almamun120/LoRa-MeshChat-Node/MeshChat-LoRa-Node-v1.5/README.md

# MeshChat LoRa রিলে নোড (ESP32 + RA-02)

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

## ফার্মওয়্যার ১.২ (অ্যাপ ২.১১-এর সাথে)

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

## ৫. টেস্ট চালানো (পিসিতে)
```bash
sudo apt install g++ libssl-dev
make -C test run                 # মেশ কোর: ১৪৮টি চেক (রিলে চেইন P1–A~LoRa~B–P2, ক্ষতি/রিট্রাই, ডিউটি সাইকেল…)
tools/interop.sh                 # অ্যাপের আসল Kotlin কোডের সাথে ক্রস-চেক (অ্যাপের কোর কম্পাইল করা থাকতে হবে)
```

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

আরও: **`docs/HOW_IT_WORKS.md`** (প্রোটোকল ও সীমাবদ্ধতা)।

## ⌨ ব্লুটুথ কীবোর্ড (১.৫)
- রিলে **BLE** কীবোর্ড (HID over GATT) জোড়া যায়; লেখা PS/2 কীবোর্ডের মতোই চ্যাটে যায়। সাধারণ ক্লাসিক-ব্লুটুথ কীবোর্ড চলবে না, শুধু BLE।
- জোড়া লাগানো: সেটআপ পেজ → "ব্লুটুথ কীবোর্ড" → 🔍 খুঁজুন (কীবোর্ডকে আগে পেয়ারিং মোডে দিন) → Pair। LCD/ওয়েবে ৬ অঙ্কের কোড আসে, সেটি কীবোর্ডে টাইপ করে Enter দিন (কিছু কীবোর্ড কোড চায় না)।
- একবার জোড়া হলে কীবোর্ড জাগলেই আপনা-আপনি যুক্ত হয়; ৪টি ফোনের সংযোগে বাধা দেয় না। কোনো নতুন তার লাগে না।
- পরীক্ষা: কী-কোড থেকে অক্ষর (`mc_hid`) পিসিতে পরীক্ষিত। ESP32-তে স্ক্যান/পেয়ারিং কোড আমি কম্পাইল বা বাস্তব কীবোর্ডে চালাইনি।
