almamun120/LoRa-MeshChat-Node/MeshChat-LoRa-Node-v1.5/docs/HOW_IT_WORKS.md

# কীভাবে কাজ করে / How the relay works

```
 ফোন (MeshChat) ──BLE──┐                                   ┌──BLE── ফোন (MeshChat)
 ফোন (MeshChat) ──BLE──┤  [রিলে A]  ~~~~ LoRa ~~~~  [রিলে B]  ├──BLE── ফোন (MeshChat)
 ওয়েব/Wi-Fi, কিবোর্ড+LCD ┘   ESP32                      ESP32   └── ওয়েব/Wi-Fi, কিবোর্ড+LCD
```

## BLE দিকে
- রিলে নিজেকে হুবহু একটি MeshChat ফোনের মতো দেখায়: একই GATT সার্ভিস/ক্যারেকটারিস্টিক UUID, একই অ্যাডভার্টাইজমেন্ট (service UUID + `proto|caps|nodeId`), একই ফ্রেম ফরম্যাট (3 বাইট হেডার), একই HELLO দিয়ে লিংক বাঁধা। **ফোনের অ্যাপে কোনো বদল লাগে না**: ফোন রিলেকে স্ক্যান করে নিজে থেকেই সংযুক্ত হয়।
- রিলের Node ID ইচ্ছা করে বড় (F0… দিয়ে শুরু) বানানো হয়, যাতে ফোনই (ছোট ID) কানেকশন খোলে; রিলে কখনো বাইরে ডায়াল করে না।
- একসাথে ৪টি ফোন পর্যন্ত।
- প্রতি ১০ সেকেন্ডে প্রতিটি ফোনকে HELLO পাঠায়, যাতে দূরের (LoRa-র ওপারের) নোডের রুট বিজ্ঞাপিত থাকে। তাই ফোন জানে "ঐ নোডে পৌঁছাতে রিলের মধ্য দিয়ে যেতে হবে।"

## LoRa দিকে
- মেশ প্যাকেট (অ্যাপের ফরম্যাট অপরিবর্তিত) ১টি বা কয়েকটি রেডিও ফ্রেমে (সর্বোচ্চ ২৫৫ বাইট) ভেঙে যায়, সর্বোচ্চ ৮ ফ্রেম (~২ KB)।
- LoRa-য় যায়: **IDENTITY (পরিচয়/পাবলিক কি), ANNOUNCE (পাবলিক বোর্ড), PRIVATE (এনক্রিপ্টেড চ্যাট), ACK, SOS**।
- LoRa-য় যায় না: ছবি, ভয়েস, কল, ফাইল (এগুলো অনেক বড়/দ্রুত; ওগুলো শুধু BLE/Wi-Fi Direct-এ চলে)।
- **ফ্লাডিং + TTL + ডুপ্লিকেট ক্যাশ:** একই প্যাকেট দুবার প্রসেস হয় না, প্রতি হপে TTL কমে। অন্য রিলে আগেই পুনঃপ্রচার করেছে শুনলে নিজের পুনঃপ্রচার বাতিল ("heard-repeat cancel")।
- **ডিউটি সাইকেল:** ট্রান্সমিটের পর airtime × (100/duty − 1) সময় চুপ থাকে (ডিফল্ট 10%)।
- **পরিচয় বীকন:** ফোন রিলের সাথে যুক্ত হলে তার সাইন করা IDENTITY রিলে মনে রাখে এবং LoRa-য় প্রচার করে (শুরুতে কয়েকবার তাড়াতাড়ি, তারপর ১২ মিনিট পরপর)। দূরের রিলে সেটা তার ফোনগুলোকে দেয়। এভাবে দুই প্রান্তের মানুষ একে অন্যের পাবলিক কি পায় এবং এন্ড-টু-এন্ড এনক্রিপ্টেড চ্যাট শুরু করতে পারে। রিলে IDENTITY-র সিগনেচার যাচাই করে, জাল পরিচয় বা বদলানো কি আটকায়।
- **অ্যাপ ২.১১ / ফার্মওয়্যার ১.২ সহযোগিতা: HELLO-তে LoRa-পথ চিহ্ন (অ্যাপ ঐ নোডে ভয়েস/ফাইল/কল বন্ধ করে),** রিলে `LORA` ক্যাপ বিট জানায়, ফোনের পুনরাবৃত্ত পরিচয় LoRa-তে পাঠায় না (শুধু নতুন পরিচয় ও বীকন), পাবলিক পোস্ট/পরিচয়ের LoRa হপ সীমা ৬, পরিচয়-অনুরোধ (টাইপ ১২) মেমরি থেকে উত্তর দেয়, ট্রান্সমিটের আগে চ্যানেল শোনে, চ্যানেল ব্যস্ত হলে বীকন ধীর করে।
- **রিট্রাই:** ফোনের পুনঃপ্রেরণ (৮, ১৬, ৩২, ৬৪, ১২০ সেকেন্ড) যেন LoRa-য় হারানো প্যাকেট ঠেকাতে পারে, তাই অন্যের জন্য প্যাকেটের "ডুপ্লিকেট" গার্ড খুব ছোট (৭–৩০ সেকেন্ড)।

## আবহাওয়া স্টেশন (১.৪)
- নতুন প্যাকেট টাইপ বা চ্যাট পোস্ট নেই: IDENTITY পেলোডের শেষে ঐচ্ছিক ঘর — `[নাম][চাবি][ই-মেইল স্লট (ফাঁকা হতে পারে)] + °C×10 (int16) + hPa×10 (uint16)`, বিগ-এন্ডিয়ান। আবহাওয়া না থাকলে বাইট আগের ফরম্যাটের হুবহু একই। সংখ্যা -60..80 °C ও 300..1100 hPa-র বাইরে হলে পরিচয়টাই ভুল ধরা হয়।
- BMP280 একবার মাপে (ফোর্সড মোড, তাপ ×২, চাপ ×১৬), ডেটাশিটের ৩২-বিট পূর্ণসংখ্যা সূত্রে ক্ষতিপূরণ (`mc_weather.cpp`)।
- আবহাওয়াসহ পরিচয় যায় (ক) মালিকের ঠিক করা ব্যবধানে, (খ) ফোন যুক্ত হলে সেই ফোনকে। সাধারণ বীকন ও পরিচয়-অনুরোধের উত্তরে আবহাওয়া থাকে না।
- রিসিভ করা রিলে ওটা কন্টাক্টের সাথে রাখে ও **প্রতিবার "খবর" ধরে** ফোন ও পরের LoRa হপে পাঠায় (সাধারণ পরিচয় শুধু নতুন হলে যায়)। পুরোনো রিডিং পরে নতুন ফোনকে "রিপ্লে" করা হয় না (নইলে বাসি তাপমাত্রা নতুন দেখাত)।
- অ্যাপ শুধু মেমরিতে (ডাটাবেসে নয়) নোড ধরে শেষ রিডিং ও পাওয়ার সময় রাখে, Nearby তালিকায় "কত আগের" দেখায়।

## রিলের নিজের চ্যাট
- রিলের একটি নিজস্ব পরিচয় (P-256 কি) আছে; কি ফ্ল্যাশে সংরক্ষিত। Setup পেজ থেকে নতুন Node ID বানানো যায়।
- **পাবলিক বোর্ডে** লিখলে ANNOUNCE প্যাকেট (সাইন করা), লেখকের নাম = ওয়েবে আপনার দেওয়া নাম।
- **প্রাইভেট** মেসেজ ফোনের মতোই এনক্রিপ্টেড (ECDH + HKDF + AES-GCM), `[আপনার নাম] লেখা` প্রিফিক্সসহ। ACK এলে ✓✓।
- ⚠️ ডিভাইসটি একটি **শেয়ারড টার্মিনাল**: এর Wi-Fi/ওয়েব/LCD-র সবাই একই পরিচয়ে লেখে এবং রিলের প্রাইভেট চ্যাট সবাই দেখতে পায়। Wi-Fi পাসওয়ার্ড তাই গুরুত্বপূর্ণ। ব্যক্তিগত কথার জন্য নিজের ফোনের অ্যাপ ব্যবহার করুন।

## সীমাবদ্ধতা
- ফোন-ফোন গ্রুপ চ্যাট: রিলে গ্রুপ মেসেজ পড়ে দেখাতে পারে (`[group]` প্রিফিক্সসহ), কিন্তু গ্রুপে লিখতে পারে না।
- ছবি/ভয়েস মেসেজ রিলের স্ক্রিনে "[photo]" বা "[voice]" লেখা দেখায়।
- রিলে ঘড়ি নেই: ওয়েব পেজ খুললে ব্রাউজারের সময় নেয় (বা অন্য প্যাকেট থেকে শেখে)।
- SF বেশি (11–12) হলে দূরত্ব বাড়ে কিন্তু একটি প্যাকেটে কয়েক সেকেন্ড লাগে এবং ডিউটি সাইকেলের কারণে মেসেজ ধীরে যায়।

## ব্লুটুথ কীবোর্ড (১.৫)
রিলে একটি `BtKeyboard` টাস্ক আলাদা থ্রেডে চলে: স্ক্যান → কানেক্ট → পেয়ারিং (প্যাসকি রিলে দেখায়) → HID রিপোর্ট নোটিফাই। রিপোর্টের বাইট `mc_hid` কী-ইভেন্টে বদলায়, তারপর PS/2-র মতোই `ChatUi`-তে যায়। এটি BLE সেন্ট্রাল হিসেবে চলে, ফোনেরা আগের মতোই রিলের সার্ভারে যুক্ত হয়।
