almamun120/LoRa-MeshChat-Node/MeshChat-LoRa-Node-v1.5/docs/app_screens/00_overview.png

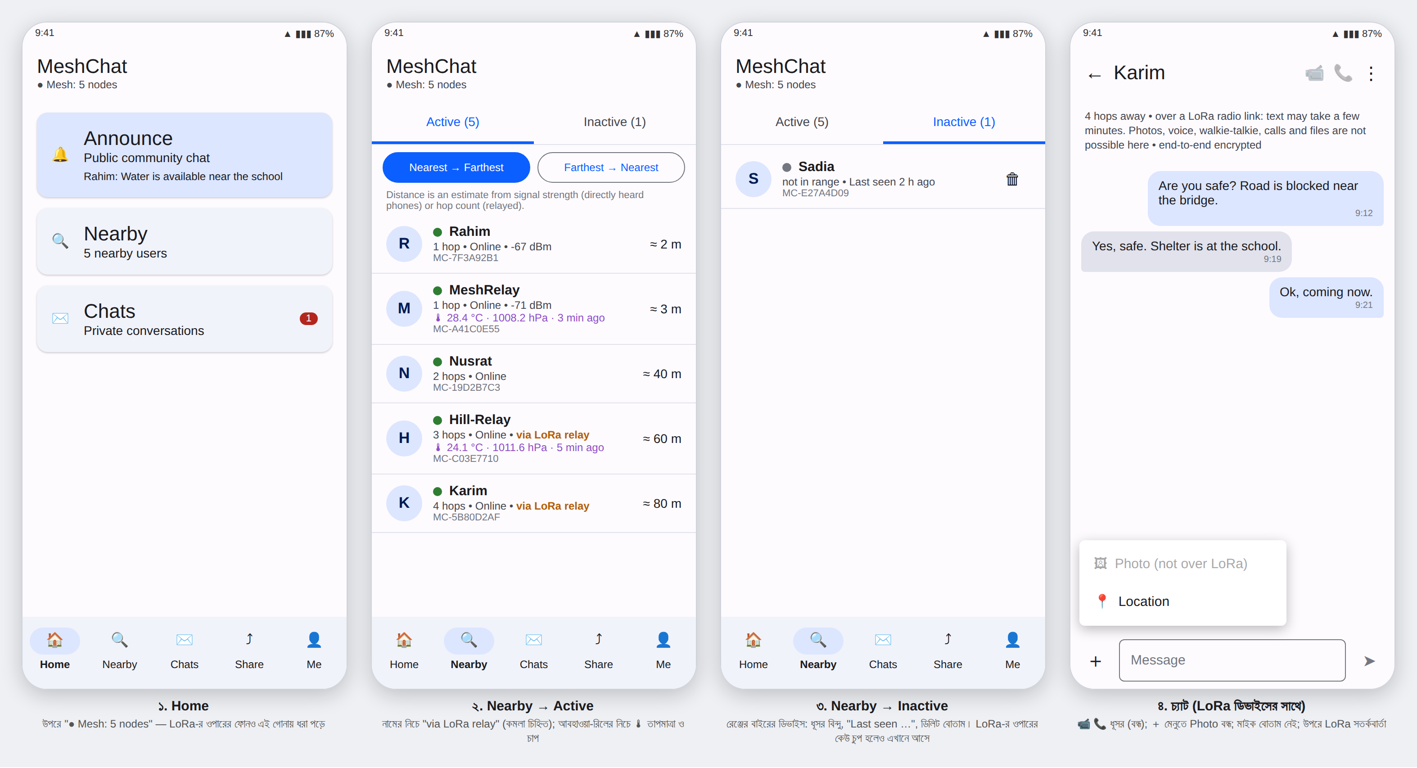
MeshChat-LoRa-Node-v1.5/docs/app_screens/00_overview.png
