almamun120/LoRa-MeshChat-Node/MeshChat-LoRa-Node-v1.5/docs/app_screens/01_home.png

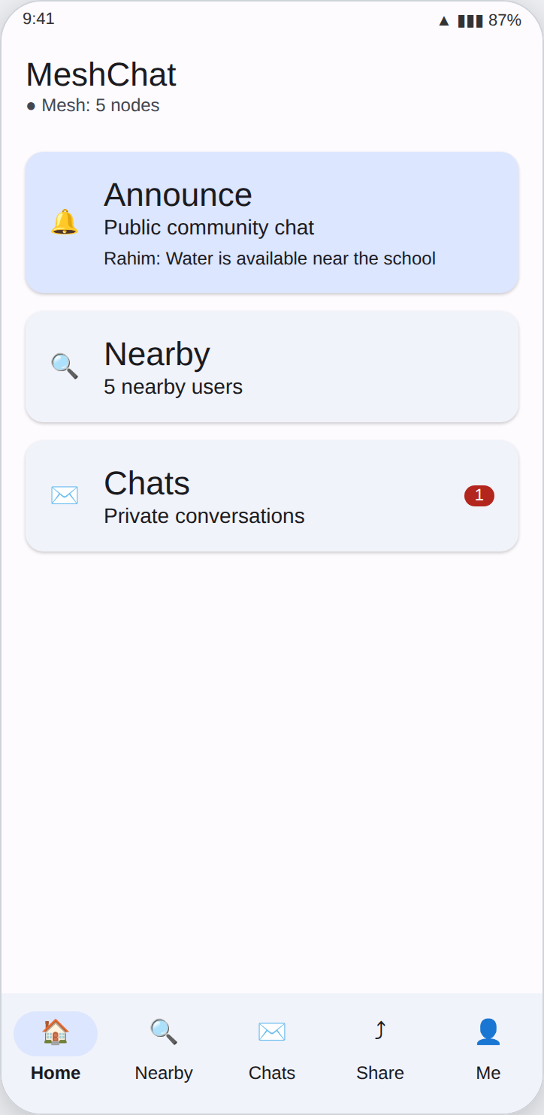
MeshChat-LoRa-Node-v1.5/docs/app_screens/01_home.png
