almamun120/LoRa-MeshChat-Node/MeshChat-LoRa-Node-v1.5/docs/app_screens/02_nearby_active.png

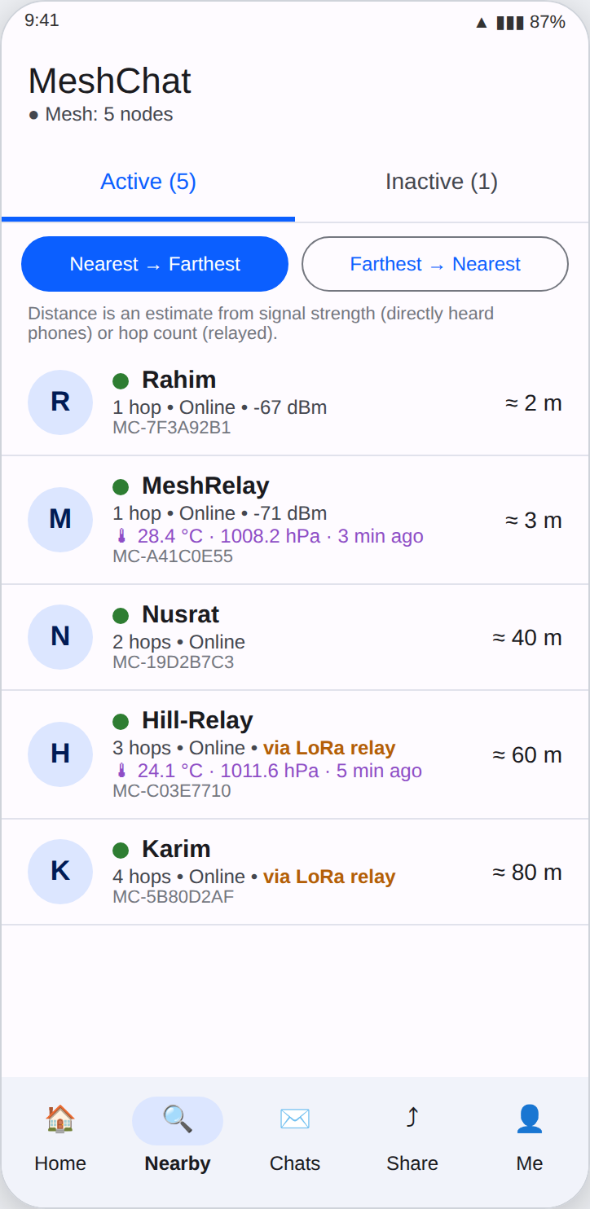
MeshChat-LoRa-Node-v1.5/docs/app_screens/02_nearby_active.png
