almamun120/LoRa-MeshChat-Node/MeshChat-LoRa-Node-v1.5/docs/app_screens/03_nearby_inactive.png

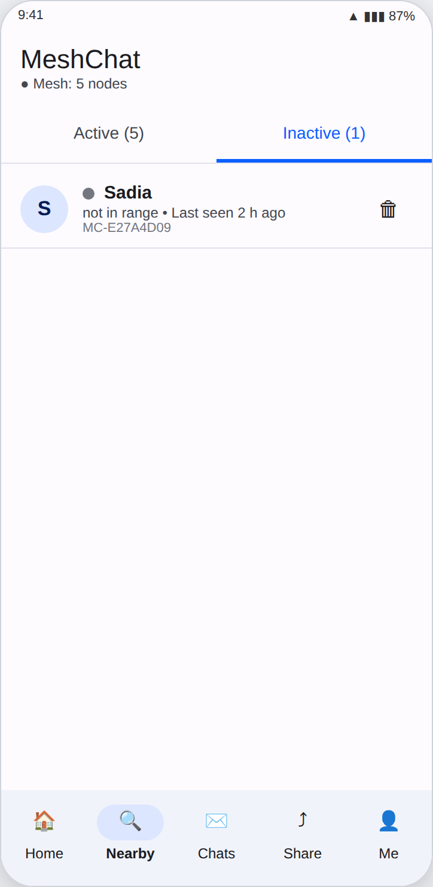
MeshChat-LoRa-Node-v1.5/docs/app_screens/03_nearby_inactive.png
