almamun120/LoRa-MeshChat-Node/MeshChat-LoRa-Node-v1.5/docs/app_screens/04_chat_lora.png

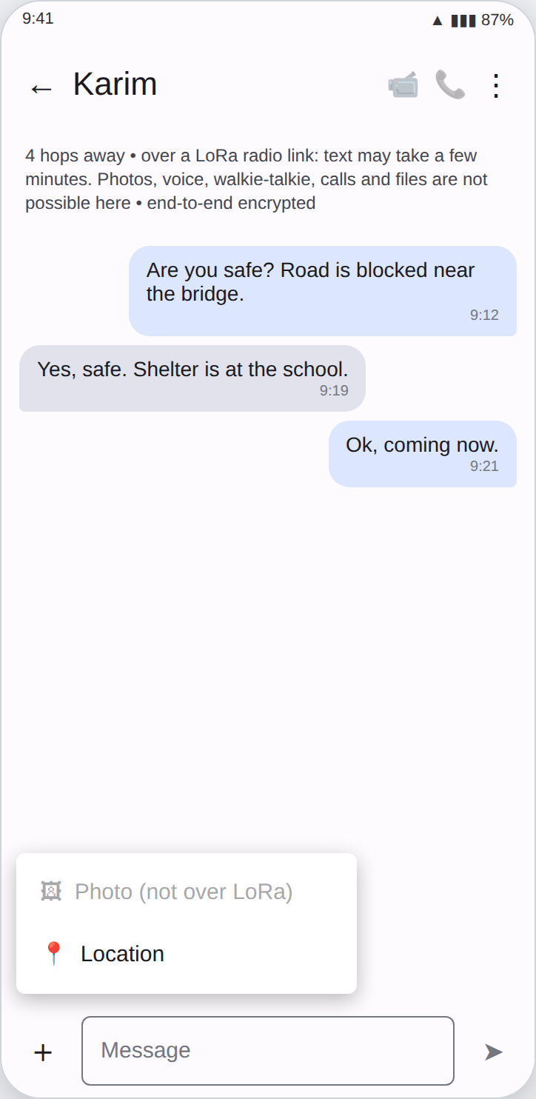
MeshChat-LoRa-Node-v1.5/docs/app_screens/04_chat_lora.png
